ezaykin/modsensor/avr/modbus/HAL/Uart.c

/*
 * Uart.c
 *
 * Created: 27.10.2018 17:26:49
 *  Author: Evgeny
 */ 

#include "../Globals.h"
#include <avr/io.h>
#include <avr/interrupt.h>
#include <util/setbaud.h> //С помощью этих макросов рассчитывается константы UBRRH_VALUE и UBRRL_VALUE

static void (*pUartIsrHandler)(uint8_t) = 0;

void UartInit(void (*IsrHandler)(uint8_t))
{
    UCSR0A = 0x00;
    UCSR0C = ((1<<UCSZ00)|(1<<UCSZ01));      //Character Size: 8 bit

    UBRR0H = UBRRH_VALUE;
    UBRR0L = UBRRL_VALUE;
    
    pUartIsrHandler=IsrHandler;
}

void UartStart()
{
    UCSR0B = (1<<RXCIE0)|(1<<RXEN0)|(1<<TXEN0);
}

void UartStop()
{
    UCSR0B = 0;
}

void UartWrite(uint8_t* pBuffer, uint16_t unSize)
{
    for (int i=0; i<unSize; ++i)
    {
        UDR0 = pBuffer[i];
        while (!(UCSR0A & (1<<UDRE0)));
    }
}

ISR(USART_RX_vect)
{
    if (pUartIsrHandler) 
    {
        (*pUartIsrHandler)(UDR0);
    }
}
