ezaykin/modsensor/avr/modbus/Uart.h

/*
 * Uart.h
 *
 * Created: 28.10.2018 14:48:08
 *  Author: Evgeny
 */ 


#ifndef UART_H_
#define UART_H_

void UartInit();
void UartStart();
void UartStop();
void UartWrite(uint8_t* pBuffer, int nSize);
void SetUartIsrHandler(void (*IsrHandler)(uint8_t));


#endif /* UART_H_ */
