ezaykin/modsensor/(commit log)

2019-04-03 [fix] UTF-8 for avr project
    [Bmp280.c, CRC16.c, EventHandlers.c, EventHandlers.h, Globals.h, PIO.c, RfReceiver.c, Timers.c]
2019-06-08 [fix] modbus timer
2019-09-23 [fix] modbus write bit
    [modbus.c]
2019-09-28 [fix] Battery warning
2019-12-08 [fix] force single coil
    [Bmp280.c, EventHandlers.c, Modbus.h, main.c, modbus.c]
2019-12-22 [add] improved stability of RF receiver
    [EventHandlers.c, Modbus.h, PIO.c, PIO.h, RfReceiver.c, RfReceiver.h, Uart.c, Uart.h]
